Tengoles/Tesis/README.md

# Tesis
Tesis de grado - Enzo Pacilio Pablo Alonso
