Tengoles/Tesis/FInal_Board_Tesis_mini_4.brd

## EAGLE design FInal_Board_Tesis_mini_4.brd (2018-10-31)

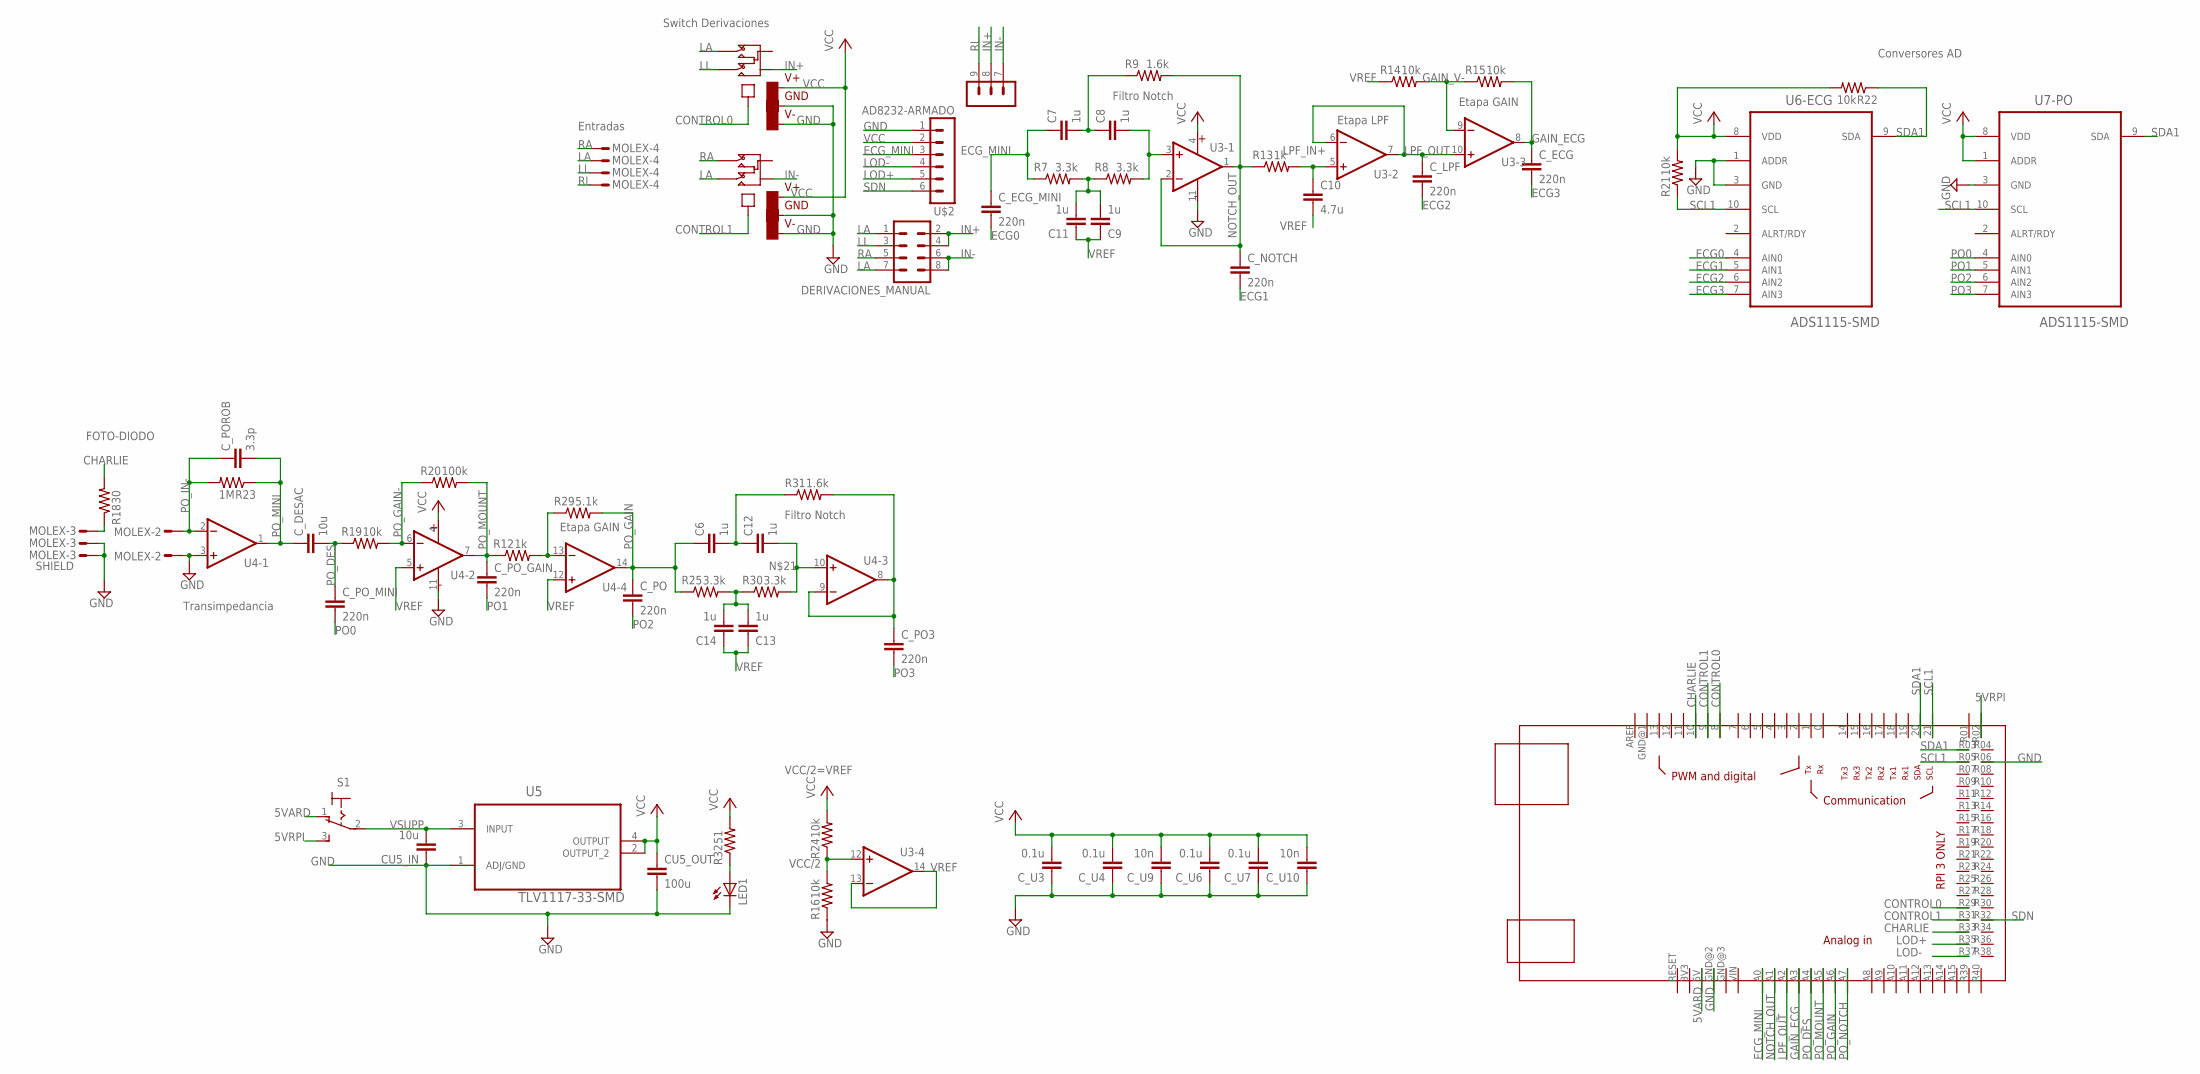
[picture p1: schematic FInal_Board_Tesis_mini_4.sch]

Parts:
C6, C7, C8, C9, C11, C12, C13, C14: 1u; C0805
C10: 4.7u; C0805
CU5_IN: 10u; C0805
CU5_OUT: 100u; C0805
C_DESAC: 10u; C0805
C_ECG: 220n; C0805
C_ECG_MINI: 220n; C0805
C_LPF: 220n; C0805
C_NOTCH: 220n; C0805
C_PO, C_PO3: 220n; C0805
C_POROB: 3.3p; C0805
C_PO_GAIN: 220n; C0805
C_PO_MINI: 220n; C0805
C_U3, C_U4, C_U6, C_U7: 0.1u; C0805
C_U9, C_U10: 10n; C0805
DERIVACIONES_MANUAL: MA04-2
LED1: LED_E; LED_1206
R7, R8, R25, R30: 3.3k; M3216
R9, R31: 1.6k; M3216
R12, R13: 1k; M3216
R14, R15, R16, R19, R21, R22, R24: 10k; M3216
R18: 30; M3216
R20: 100k; M3216
R23: 1M; M3216
R29: 5.1k; M3216
R32: 51; M3216
S1: 320-916
U3, U4: OPA4348-SMD; 14TSSOP
U5: TLV1117-33-SMD; SOT223
U6-ECG, U7-PO: ADS1115-SMD; 10MSOP
U9, U10: MAX4528-SMD; 8MSOP-C/PTO
U$1: MEGA_DEVICE; MEGABOX
U$2: AD8232-ARMADO; PINES-ECG
U$3: MOLEX-3
U$4: MOLEX-2
U$5: MOLEX-4

Connections:
5VARD: S1.1 (O), U$1.5V
5VRPI: S1.3 (S), U$1.R02 (5V1)
CHARLIE: R18.2, U$1.10, U$1.R33 (GPIO13)
CONTROL0: U9.4 (IN), U$1.8, U$1.R29 (GPIO5)
CONTROL1: U10.4 (IN), U$1.9, U$1.R31 (GPIO6)
ECG0: C_ECG_MINI.2, U6-ECG.4 (AIN0)
ECG1: C_NOTCH.2, U6-ECG.5 (AIN1)
ECG2: C_LPF.2, U6-ECG.6 (AIN2)
ECG3: C_ECG.2, U6-ECG.7 (AIN3)
ECG_MINI: C7.1, C_ECG_MINI.1, R7.1, U$1.A0, U$2.3 (OUT)
GAIN_ECG: C_ECG.1, R15.2, U3.8 (OUT), U$1.A3
GAIN_V-: R14.2, R15.1, U3.9 (-IN)
GND: CU5_IN.1, CU5_OUT.2, C_U3.1, C_U4.1, C_U6.1, C_U7.1, C_U9.1, C_U10.1, LED1.C, R16.1, U3.11 (V-), U4.3 (+IN), U4.11 (V-), U5.1 (ADJ/GND), U6-ECG.1 (ADDR), U6-ECG.3 (GND), U7-PO.3 (GND), U9.3 (GND), U9.5 (V-), U10.3 (GND), U10.5 (V-), U$1.GND@2 (GND), U$1.R06 (GND), U$2.1 (GND), U$3.2, U$3.3, U$4.2
IN+: DERIVACIONES_MANUAL.2, DERIVACIONES_MANUAL.4, U9.6 (Y), U$2.8 (LA)
IN-: DERIVACIONES_MANUAL.6, DERIVACIONES_MANUAL.8, U10.6 (Y), U$2.7 (RA)
LA: DERIVACIONES_MANUAL.1, DERIVACIONES_MANUAL.7, U9.1 (A), U10.2 (B), U$5.2
LL: DERIVACIONES_MANUAL.3, U9.2 (B), U$5.3
LOD+: U$1.R35 (GPIO19), U$2.5 (LOD+)
LOD-: U$1.R37 (GPIO26), U$2.4 (LOD-)
LPF_IN+: C10.1, R13.2, U3.5 (+IN)
LPF_OUT: C_LPF.1, U3.6 (-IN), U3.7 (OUT), U3.10 (+IN), U$1.A2
unnamed: C6.2, C12.1, R31.1
unnamed: C7.2, C8.1, R9.1
unnamed: C8.2, R8.2, U3.3 (+IN)
unnamed: C9.2, C11.2, R7.2, R8.1
unnamed: R18.1, U$3.1
unnamed: C13.2, C14.2, R25.2, R30.1
unnamed: R12.2, R29.1, U4.13 (-IN)
unnamed: LED1.A, R32.1
unnamed: C12.2, R30.2, U4.10 (+IN)
NOTCH_OUT: C_NOTCH.1, R9.2, R13.1, U3.1 (OUT), U3.2 (-IN), U$1.A1
PO0: C_PO_MINI.2, U7-PO.4 (AIN0)
PO1: C_PO_GAIN.2, U7-PO.5 (AIN1)
PO2: C_PO.2, U7-PO.6 (AIN2)
PO3: C_PO3.2, U7-PO.7 (AIN3)
PO_DES: C_DESAC.2, C_PO_MINI.1, R19.1, U$1.A4
PO_GAIN: C6.1, C_PO.1, R25.1, R29.2, U4.14 (OUT), U$1.A6
PO_GAIN-: R19.2, R20.1, U4.6 (-IN)
PO_IN-: C_POROB.1, R23.2, U4.2 (-IN), U$4.1
PO_MINI: C_DESAC.1, C_POROB.2, R23.1, U4.1 (OUT)
PO_MOUNT: C_PO_GAIN.1, R12.1, R20.2, U4.7 (OUT), U$1.A5
PO_NOTCH: C_PO3.1, R31.2, U4.8 (OUT), U4.9 (-IN), U$1.A7
RA: DERIVACIONES_MANUAL.5, U10.1 (A), U$5.1
RL: U$2.9 (RL), U$5.4
SCL1: R21.1, U6-ECG.10 (SCL), U7-PO.10 (SCL), U$1.21, U$1.R05 (SCL1)
SDA1: R22.1, U6-ECG.9 (SDA), U7-PO.9 (SDA), U$1.20, U$1.R03 (SDA1)
SDN: U$1.R32 (GPIO12), U$2.6 (!SDN)
VCC: CU5_OUT.1, C_U3.2, C_U4.2, C_U6.2, C_U7.2, C_U9.2, C_U10.2, R21.2, R22.2, R24.2, R32.2, U3.4 (V+), U4.4 (V+), U5.2 (OUTPUT_2), U5.4 (OUTPUT), U6-ECG.8 (VDD), U7-PO.1 (ADDR), U7-PO.8 (VDD), U9.8 (V+), U10.8 (V+), U$2.2 (3.3V)
VCC/2: R16.2, R24.1, U3.12 (+IN)
VREF: C9.1, C10.2, C11.1, C13.1, C14.1, R14.1, U3.13 (-IN), U3.14 (OUT), U4.5 (+IN), U4.12 (+IN)
VSUPP: CU5_IN.2, S1.2, U5.3 (INPUT)

Notes on the sheet:
Filtro Notch
Etapa LPF
VCC/2=VREF
Etapa GAIN
FOTO-DIODO
Switch Derivaciones
Entradas
Conversores AD
SHIELD
Transimpedancia

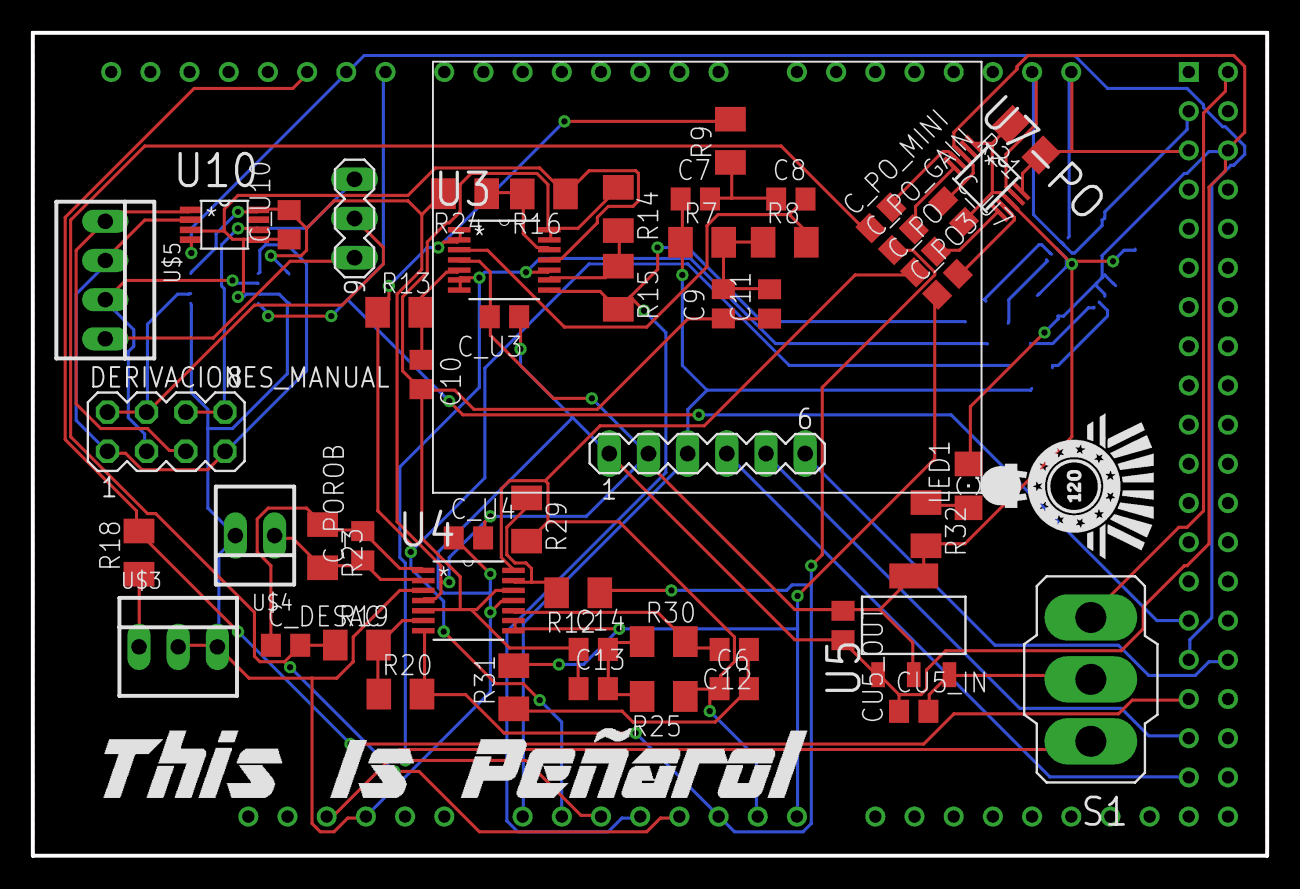
[picture p2: board FInal_Board_Tesis_mini_4.brd from above]

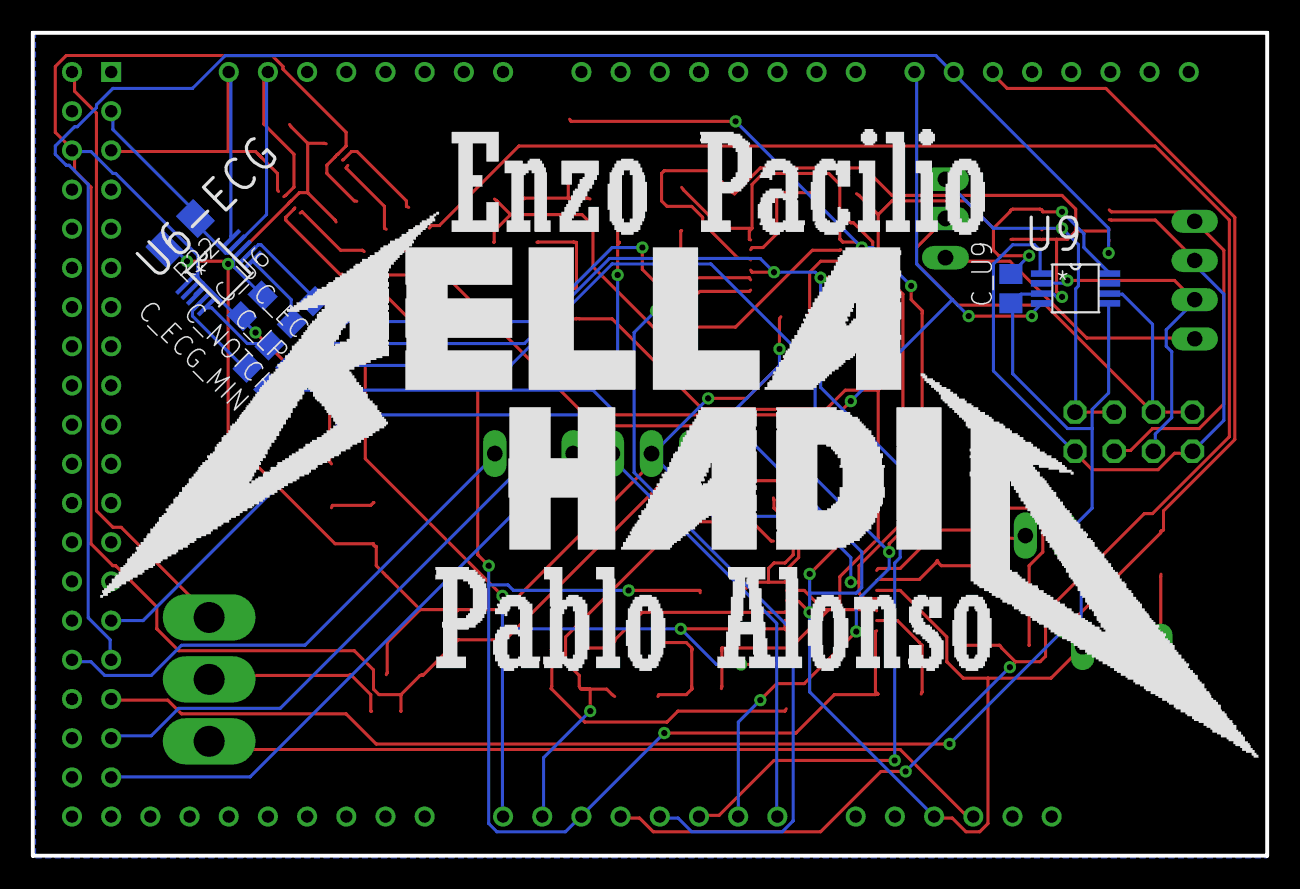
[picture p3: board FInal_Board_Tesis_mini_4.brd from below]

Board: 2 copper layers, 80.0 x 53.3 mm, 62 parts (9 on the bottom side), 51 nets.
