Tengoles/Tesis/(commit log)

2018-01-16 promedio de samples
2018-01-16 nueva forma de leer adc
2018-03-15 agregar funcion de filtrado
2018-03-25 Modulo adaptado para controlar el ADC
2018-03-26 pila de mierda
2018-04-26 archivo con datos de Enzo para pruebas
2018-04-26 cambio de nombre a la libreria principal
2018-04-26 version mejorada de adc
2018-05-02 prueba de filtros
2018-10-28 agregar este script, es casi lo mismo que adc2 pero con GUI y guardado de datos en csv
2018-10-31 Archivos del esquematico y board en Eagle
    Archivos del esquematico y board en Eagle
    [FInal_Board_Tesis_mini_4.brd, FInal_Board_Tesis_mini_4.sch]
2018-12-19 Processing files 4 Arduino Mega
    lml
